andhikanarawangsa/ML-KEM_Unified_Accelerator_DE10Nano/media/dfd2_p1_bus_csr.png

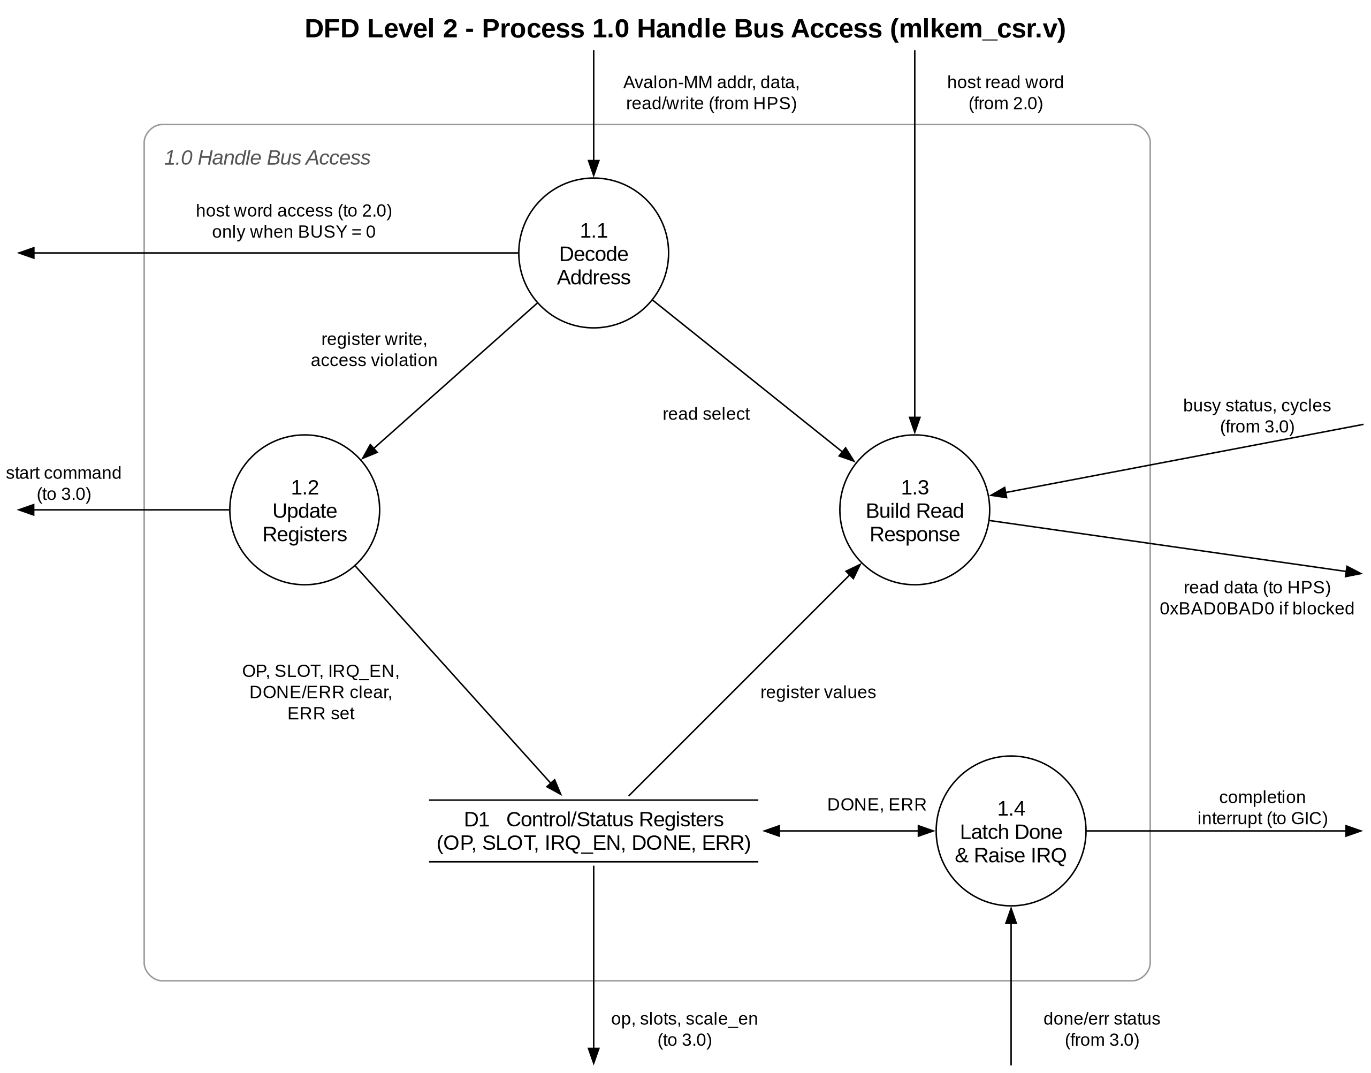
media/dfd2_p1_bus_csr.png
