andhikanarawangsa/ML-KEM_Unified_Accelerator_DE10Nano/media/dfd2_p2_scratchpad.png

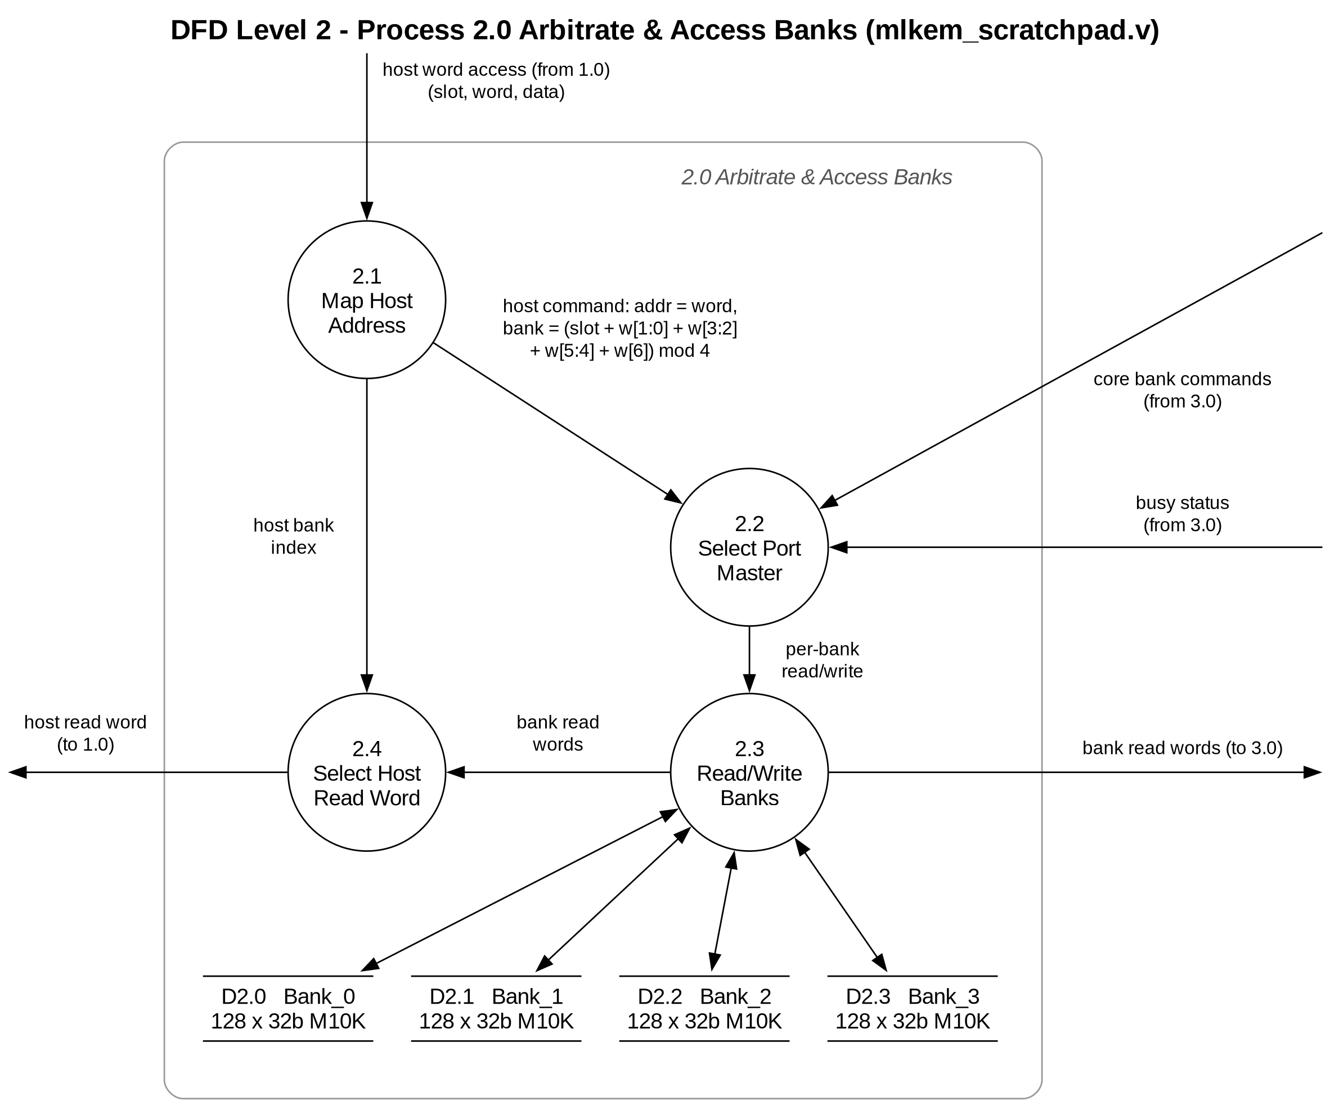
media/dfd2_p2_scratchpad.png
