andhikanarawangsa/ML-KEM_Unified_Accelerator_DE10Nano/media/dfd2_p3_controller.png

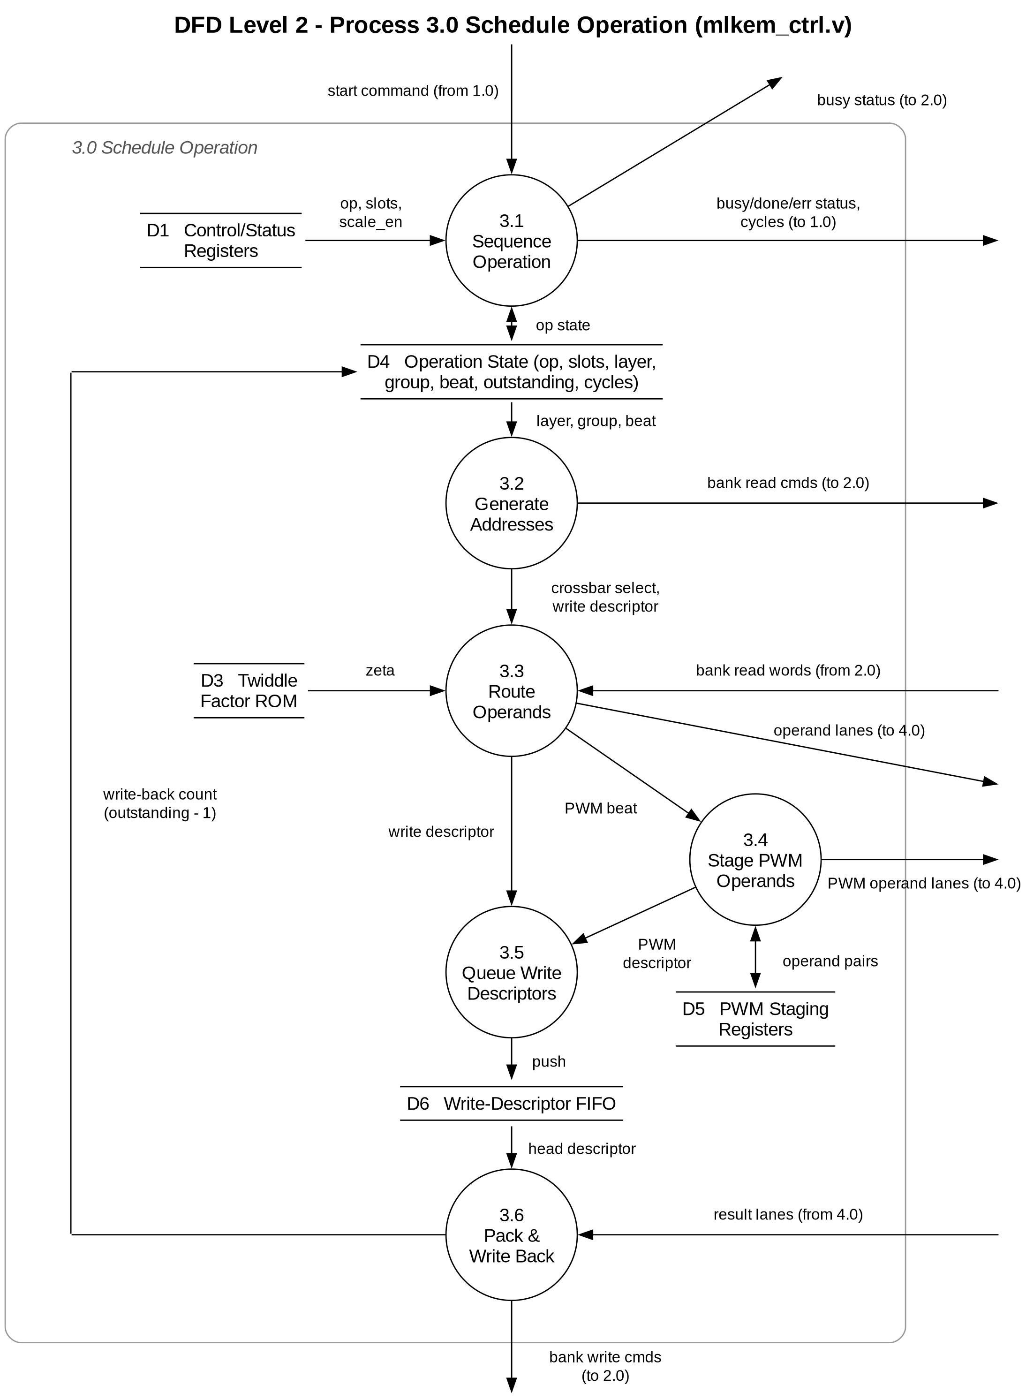
media/dfd2_p3_controller.png
