andhikanarawangsa/ML-KEM_Unified_Accelerator_DE10Nano/media/dfd2_p4_arith_core.png

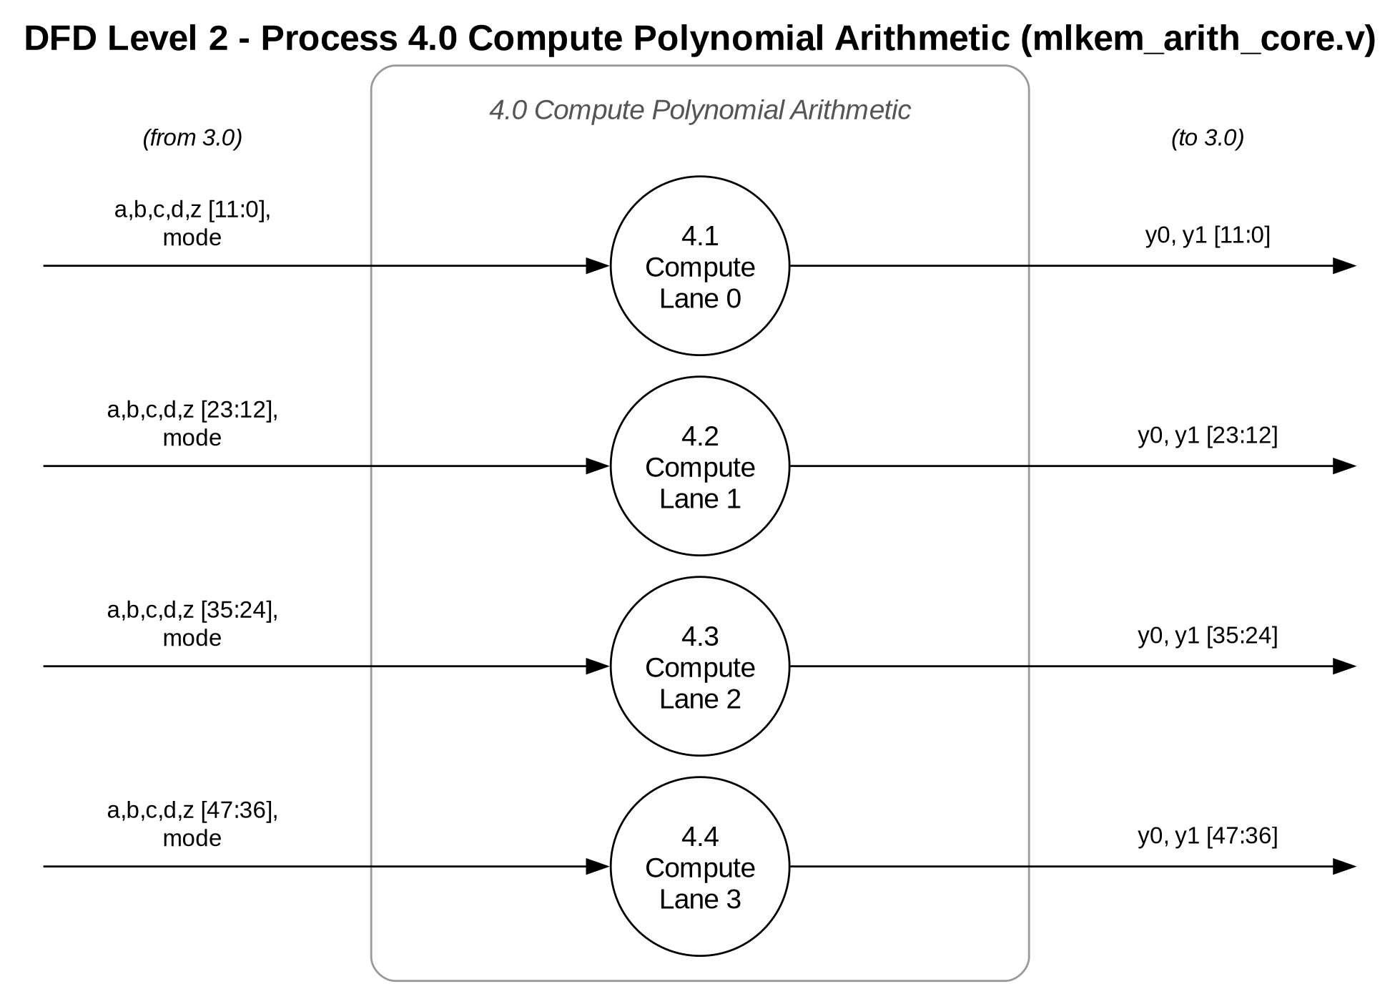
media/dfd2_p4_arith_core.png
