andhikanarawangsa/ML-KEM_Unified_Accelerator_DE10Nano/media/dfd3_p4_1_pe.png

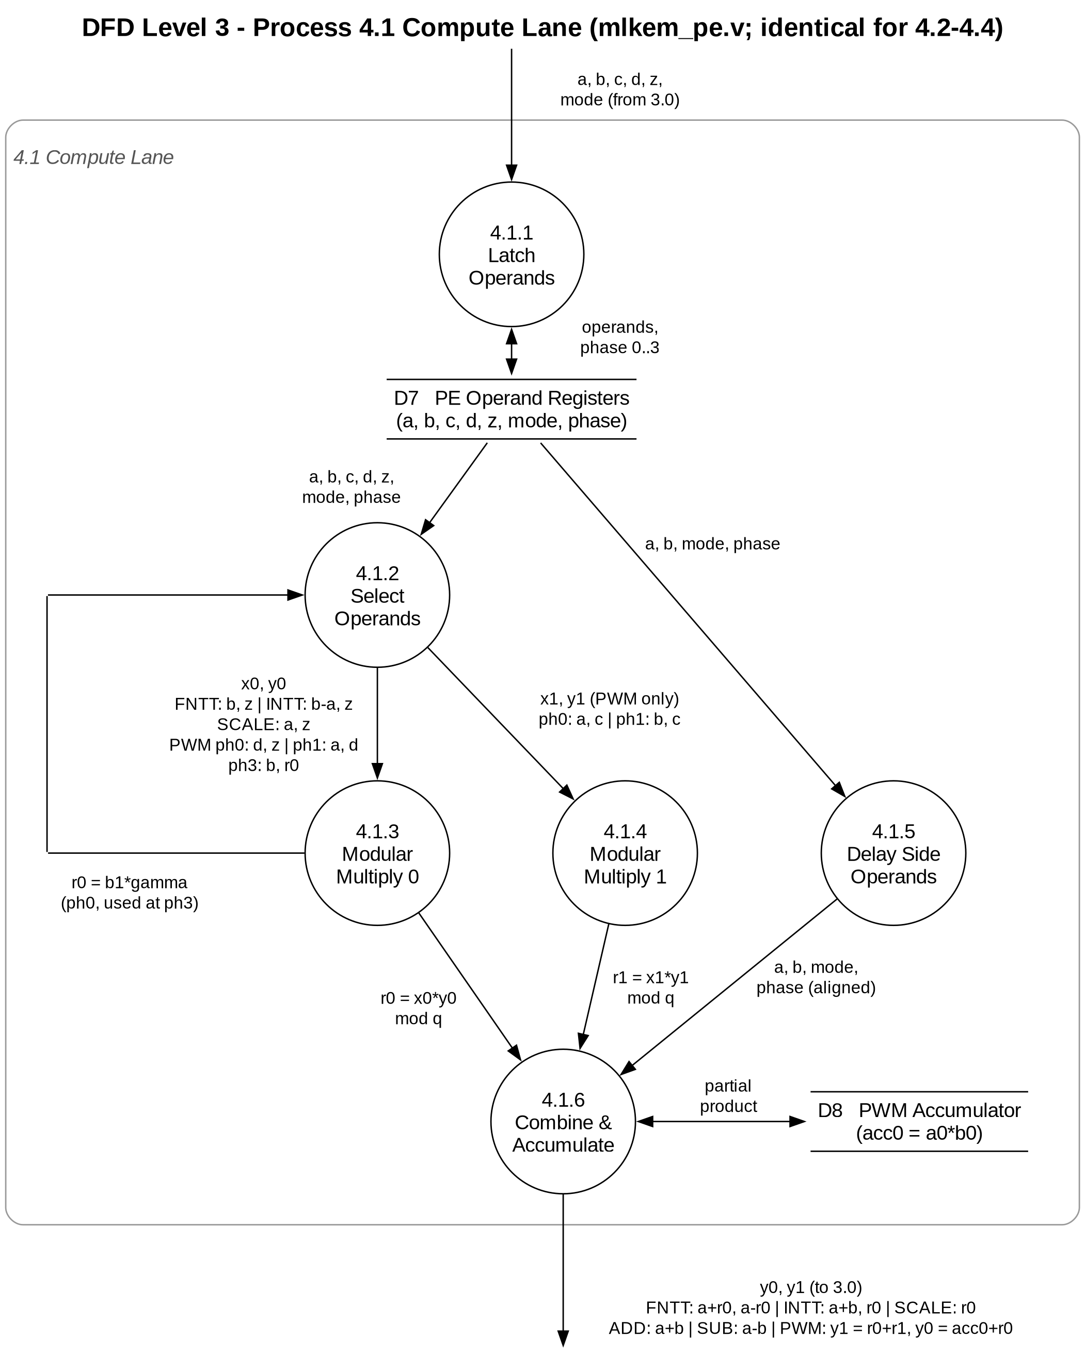
media/dfd3_p4_1_pe.png
