andhikanarawangsa/ML-KEM_Unified_Accelerator_DE10Nano/media/dfd4_p4_1_3_modmul.png

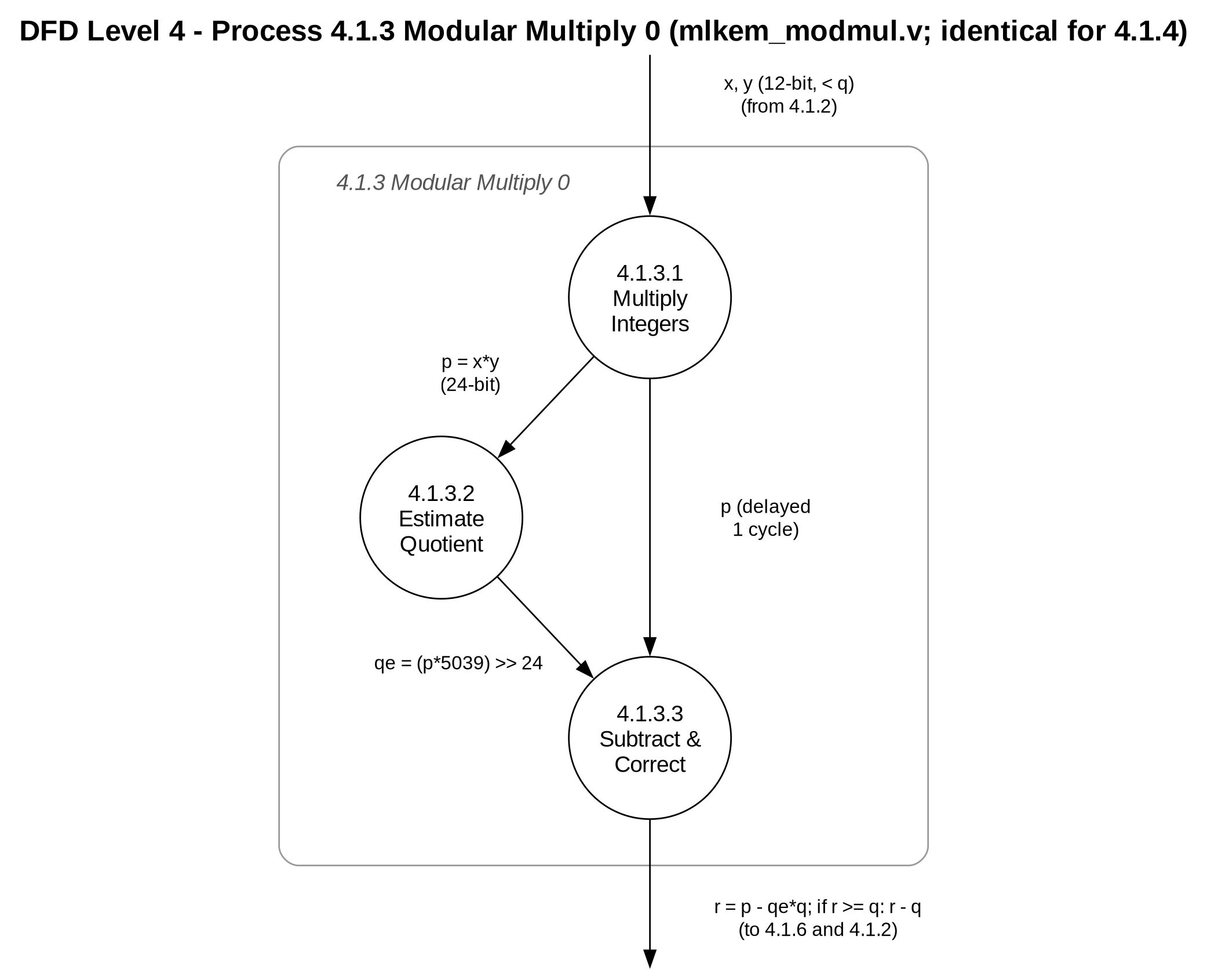
media/dfd4_p4_1_3_modmul.png
