andhikanarawangsa/ML-KEM_Unified_Accelerator_DE10Nano/media/waveform_mlkem_full_chain.png

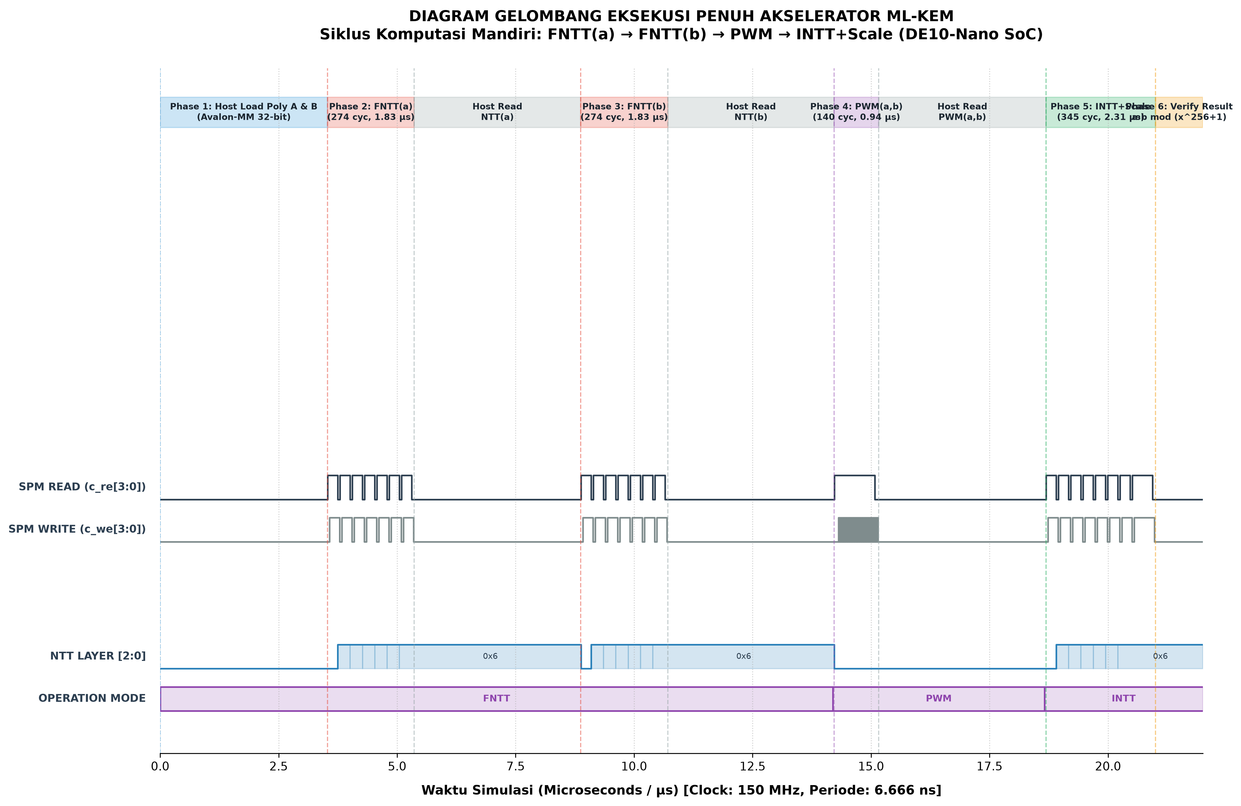
media/waveform_mlkem_full_chain.png
