andhikanarawangsa/ML-KEM_Unified_Accelerator_DE10Nano/media/waveform_pwm_zoom.png

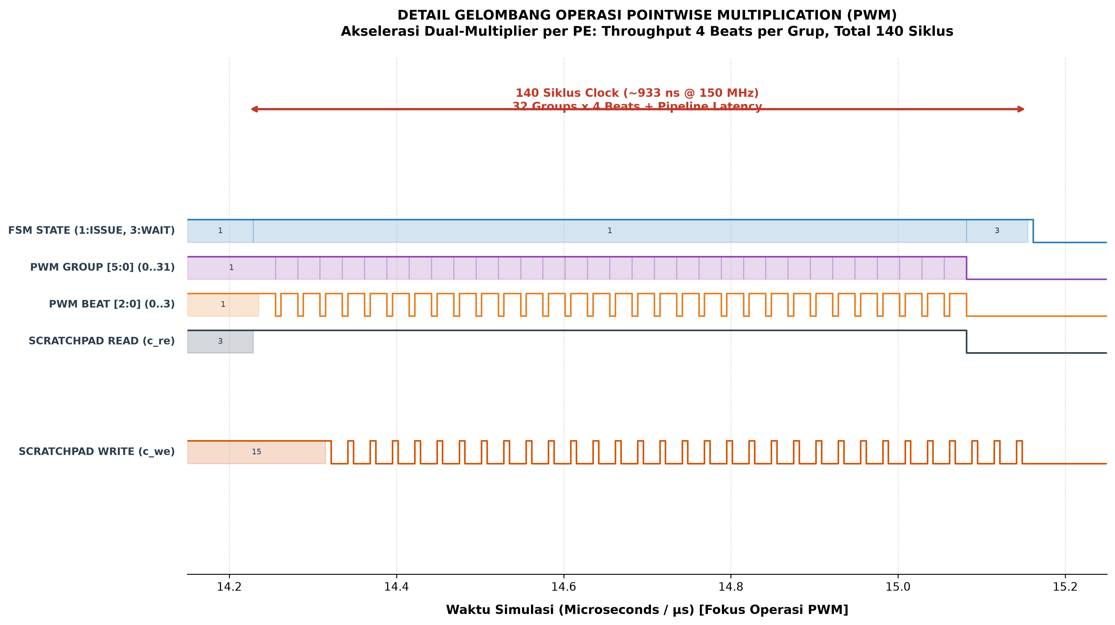
media/waveform_pwm_zoom.png
