andhikanarawangsa/ML-KEM_Unified_Accelerator_DE10Nano/(commit log)

2026-10-08 checkpoint: baseline before dual-multiplier PWM optimization
2026-10-08 PWM: dual-multiplier PE (II 5->4, 172->140 cycles); CSR busy guard + exact mem decode
2026-10-08 docs & rtl: add technical report, synthesis flow (SDC/Tcl), dual-mult PE, and update gitignore
2026-10-08 docs & sim: add automated testbench waveform flow, gtkwave config, and high-res proposal figures
